YXG001/Vacuum-3d-printer-ender3-/CAD_V2/line_base.STEP

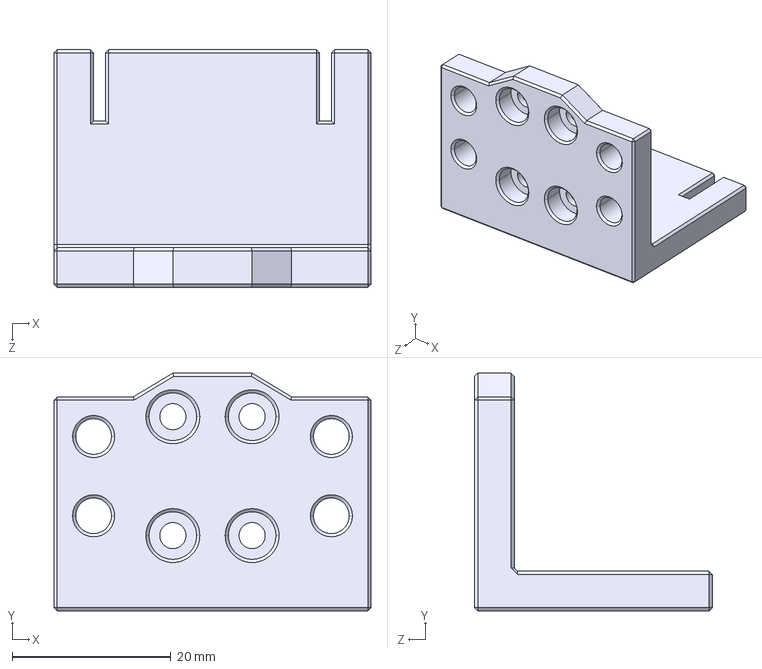
[picture p44: CAD file, 2025-03-07]
CAD_V2/line_base.STEP
40.0 x 30.0 x 30.0 mm
