YXG001/Vacuum-3d-printer-ender3-/mgn9c.SLDPRT

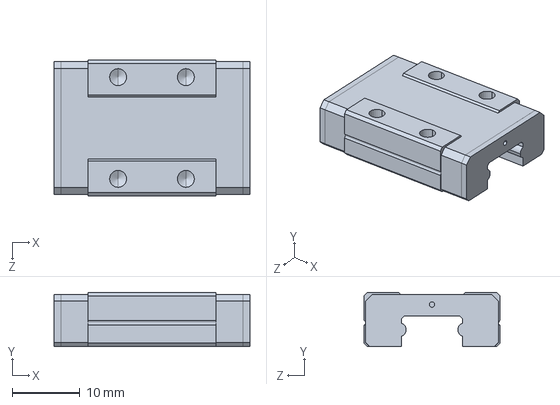
[picture p45: CAD file, 2025-03-07]
mgn9c.SLDPRT
28.9 x 8.00 x 20.0 mm
