YXG001/Vacuum-3d-printer-ender3-/CAD_V2/V6_ad_2_down.STEP

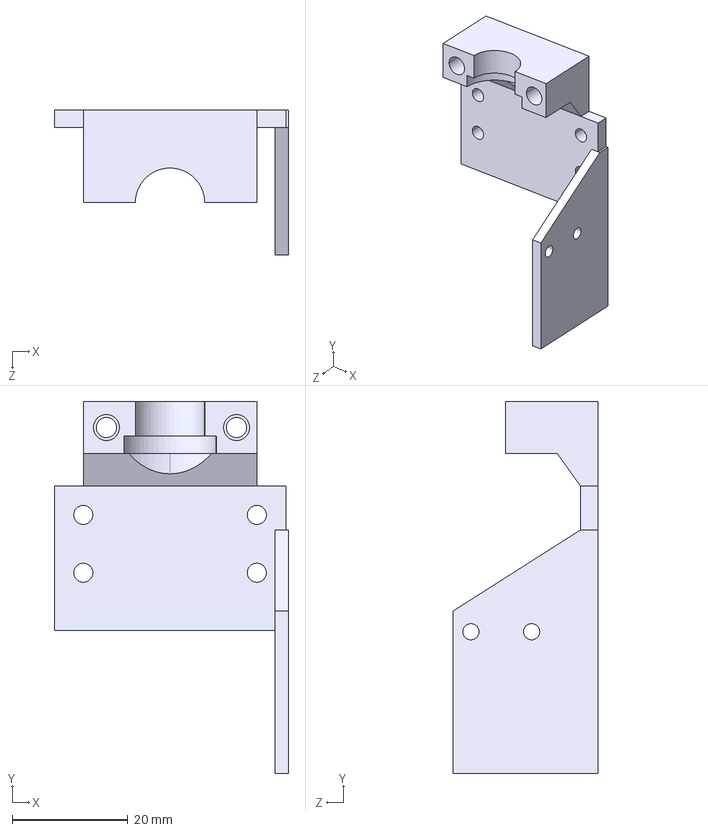
[picture p46: CAD file, 2025-03-07]
CAD_V2/V6_ad_2_down.STEP
40.5 x 64.3 x 25.0 mm
