YXG001/Vacuum-3d-printer-ender3-/mgnr9.SLDPRT

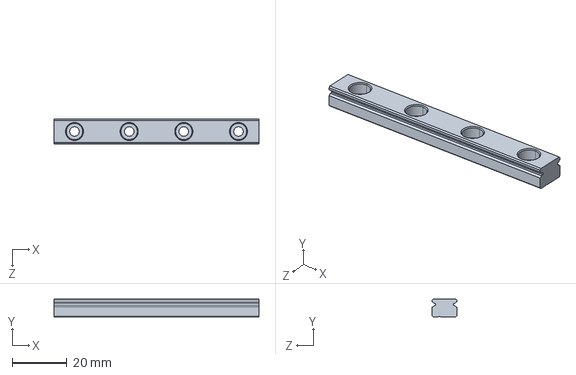
[picture p47: CAD file, 2025-03-07]
mgnr9.SLDPRT
75.0 x 6.50 x 9.00 mm
