YXG001/Vacuum-3d-printer-ender3-/CAD_V2/V6_ad_2_up.STEP

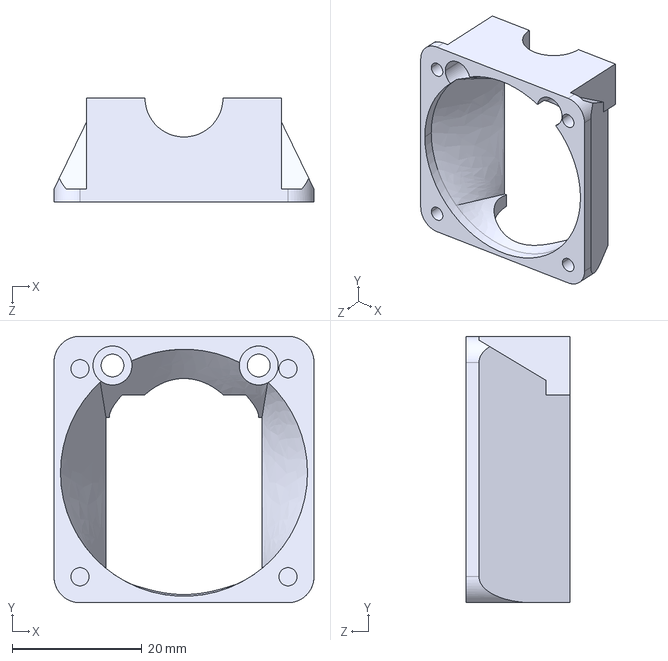
[picture p48: CAD file, 2025-03-07]
CAD_V2/V6_ad_2_up.STEP
40.0 x 41.0 x 16.0 mm
