YXG001/Vacuum-3d-printer-ender3-/CAD_V2/V6_ad_2a.SLDPRT

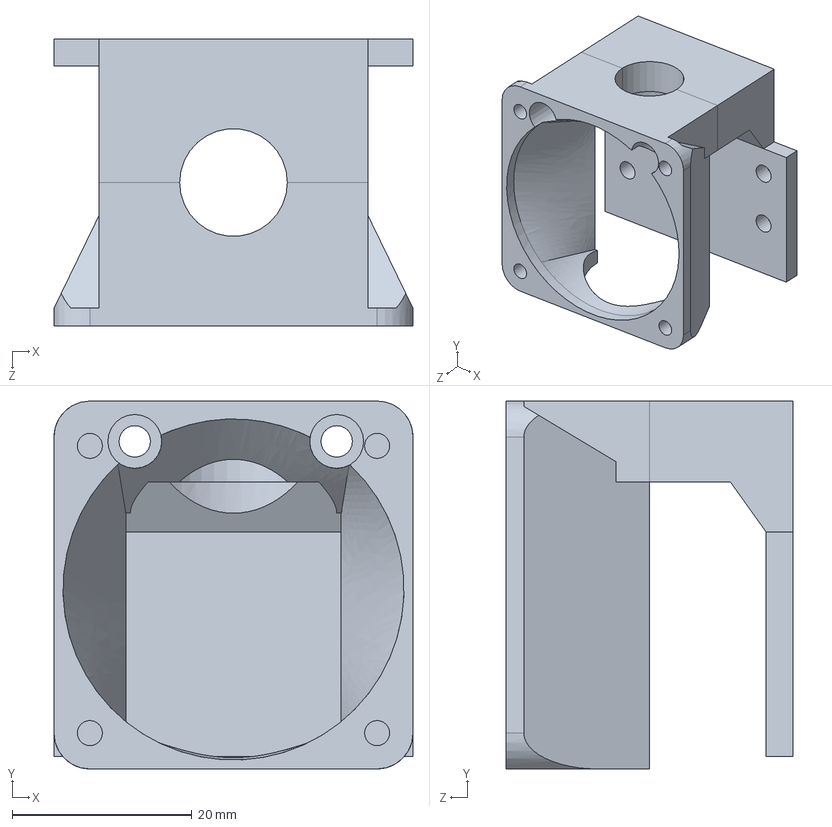
[picture p49: CAD file, 2025-03-07]
CAD_V2/V6_ad_2a.SLDPRT
40.0 x 41.0 x 32.0 mm
