YXG001/Vacuum-3d-printer-ender3-/CAD_V2/V6_ad.STEP

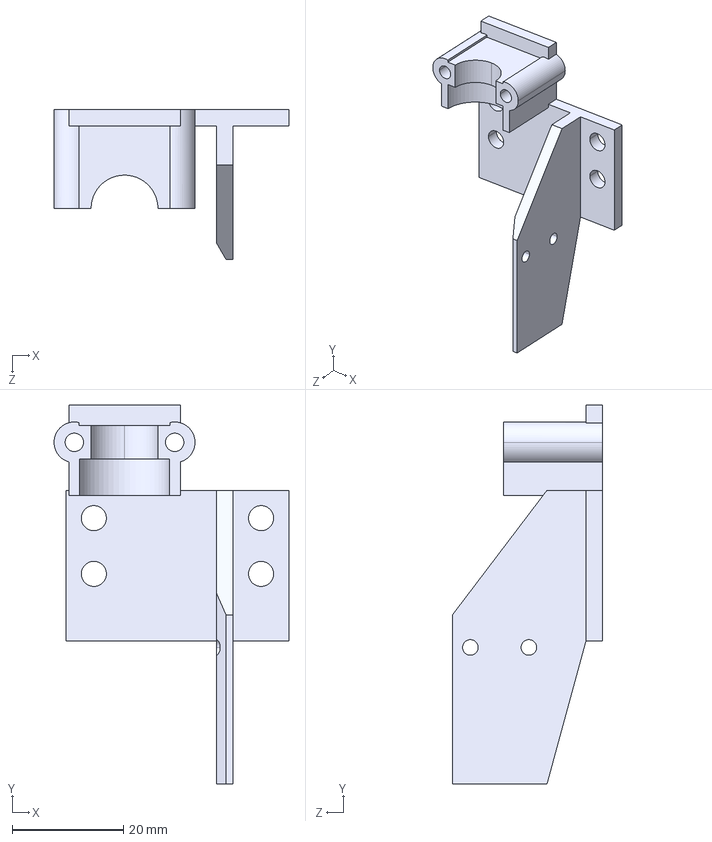
[picture p50: CAD file, 2025-02-25]
CAD_V2/V6_ad.STEP
42.1 x 68.0 x 27.0 mm
