YXG001/Vacuum-3d-printer-ender3-/CAD/newest/V6_adapter_up.STEP

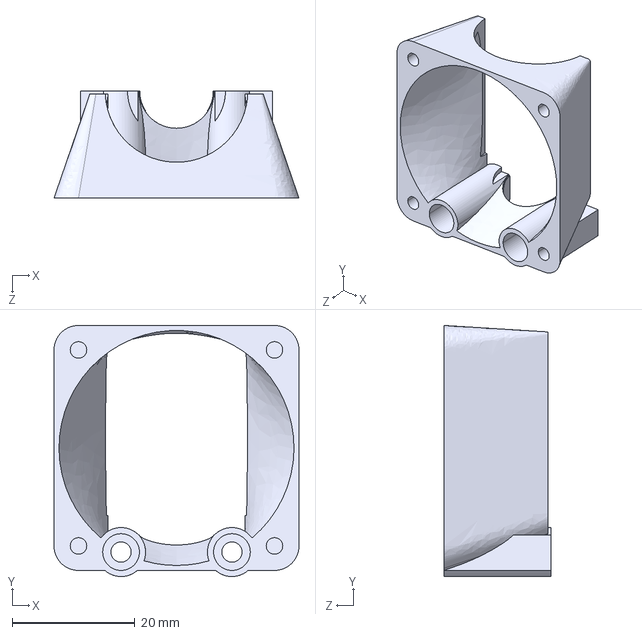
[picture p51: CAD file, 2025-02-25, an earlier design]
CAD/newest/V6_adapter_up.STEP
40.0 x 41.0 x 17.5 mm
