YXG001/Vacuum-3d-printer-ender3-/CAD/old/ender3_v.STEP

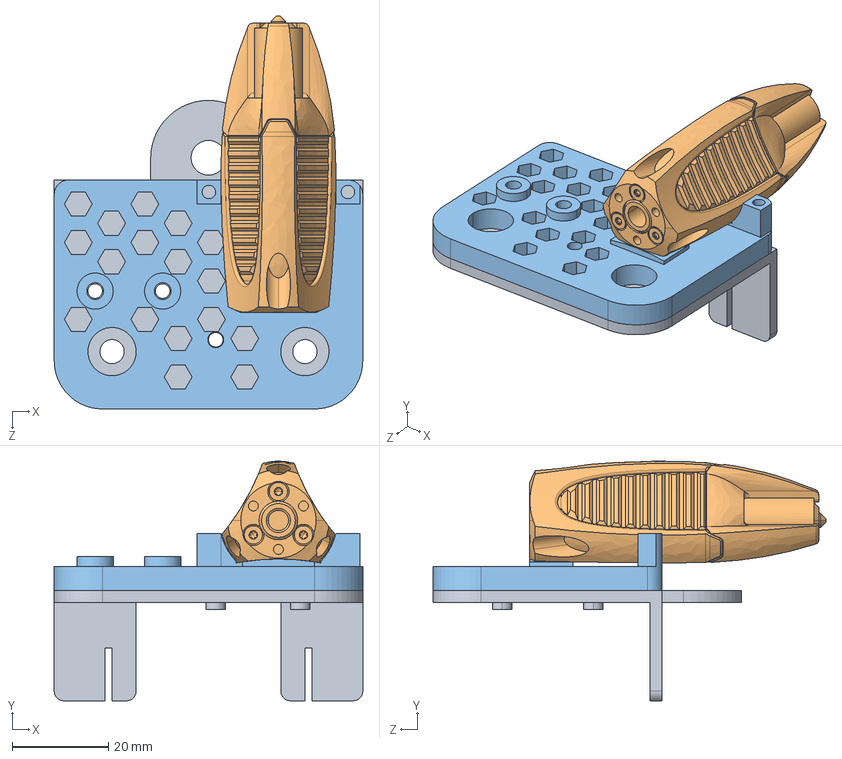
[picture p52: CAD file, 2025-01-16, an earlier design]
CAD/old/ender3_v.STEP
64.0 x 49.7 x 81.5 mm
ender3_文件夹 333
INo Trident Mockup 032023
ender3_ad
