YXG001/Vacuum-3d-printer-ender3-/CAD/newest/ender3_v5.SLDASM

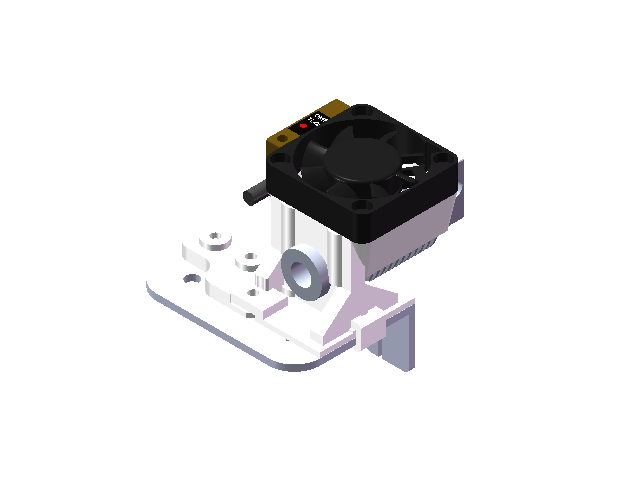
[picture p53: CAD file, 2025-02-13, an earlier design]
CAD/newest/ender3_v5.SLDASM
ender3_文件夹 333(2)
ender3_ad5B
OMRON TL-Q5MC1-Z
ender3_ad5C
e3d nozzle (0.4)
e3d heaterblock
e3d heat break
e3d heatsink
V6_adapter_down
404010 fan v5
V6_adapter_up
