YXG001/Vacuum-3d-printer-ender3-/CAD/newest/INO_head.SLDASM

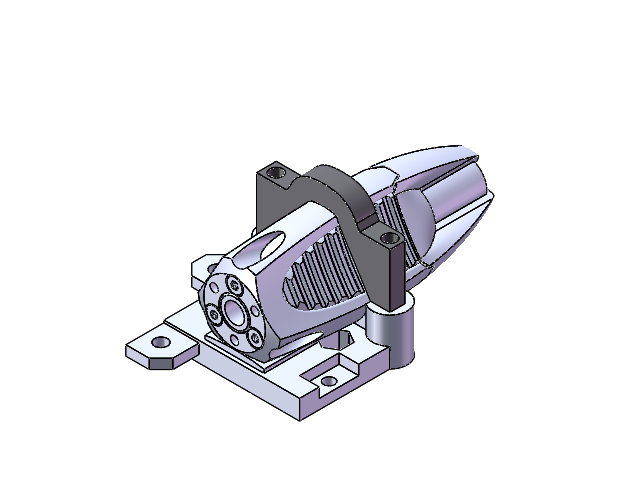
[picture p54: CAD file, 2025-02-13, an earlier design]
CAD/newest/INO_head.SLDASM
ender3_ad
INo Trident Mockup 032023(2)
eBom-FreeParts
