YXG001/Vacuum-3d-printer-ender3-/CAD/ender3_v.STEP.SLDASM

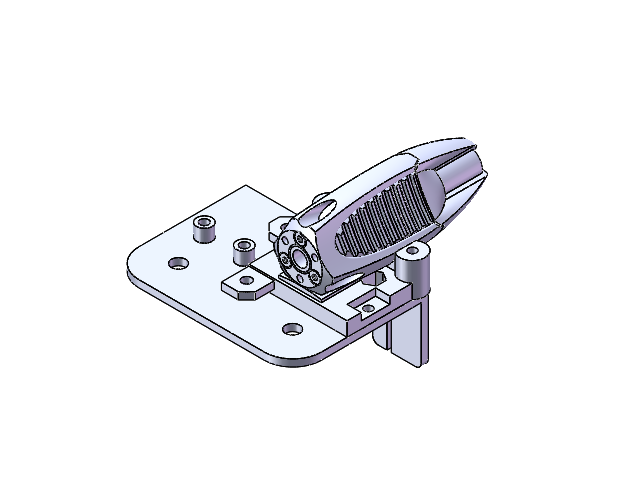
[picture p55: CAD file, 2025-02-13, an earlier design]
CAD/ender3_v.STEP.SLDASM
ender3_ad
INo Trident Mockup 032023(2)
ender3_文件夹 333(2)
