YXG001/Vacuum-3d-printer-ender3-/CAD/ender3_v3.SLDASM

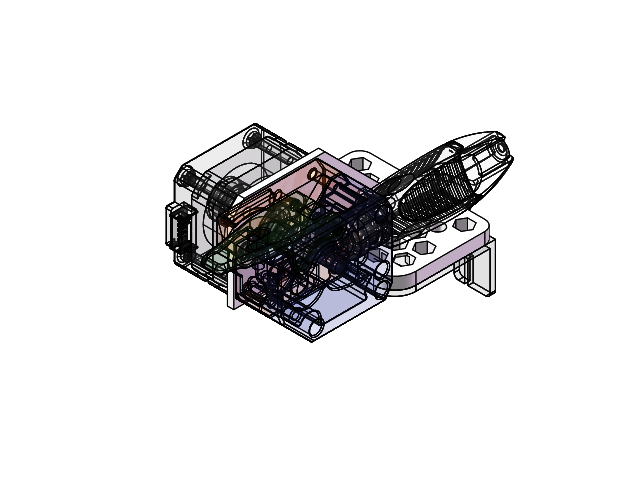
[picture p56: CAD file, 2025-01-16, an earlier design]
CAD/ender3_v3.SLDASM
ender3_文件夹 333
ender3_ad3
INo Trident Mockup 032023
Lever
BMG bottom part
e3d slimline stepper motor 0.9deg v1.1
bmg_ad2
