YXG001/Vacuum-3d-printer-ender3-/CAD/ender3_v-ASUS.SLDASM

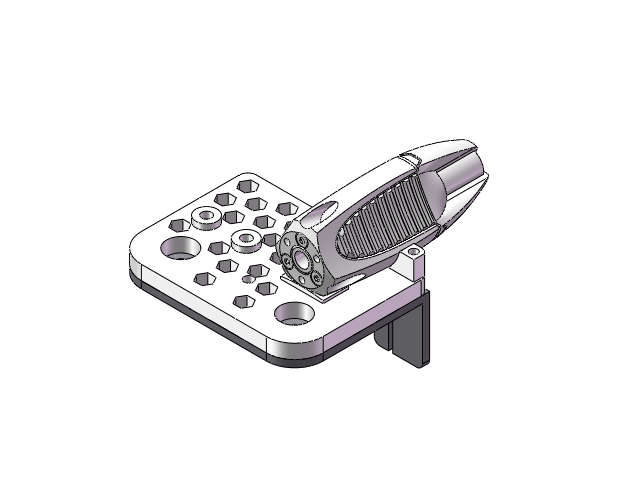
[picture p59: CAD file, 2025-01-16, an earlier design]
CAD/ender3_v-ASUS.SLDASM
ender3_文件夹 333
INo Trident Mockup 032023
ender3_ad
