YXG001/Vacuum-3d-printer-ender3-/CAD/PCB base.SLDASM

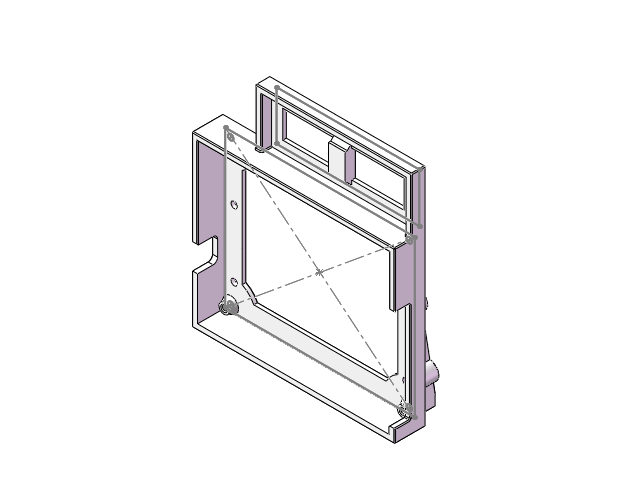
[picture p60: CAD file, 2025-01-16, an earlier design]
CAD/PCB base.SLDASM
INO base down
INO base down2
