YXG001/Vacuum-3d-printer-ender3-/(list of files, cad)

Other CAD files:
CAD/root.SLDASM
CAD/404010 fan v5.SLDPRT
CAD/Ender3_文件夹 333.step
CAD/Hotend v6.step
CAD/INO base.STEP
CAD/INo Trident Mockup 032023(2).SLDPRT
CAD/INo Trident Mockup 032023.SLDPRT
CAD/INo Trident Mockup 032023.step
CAD/bmg_ad.SLDPRT
CAD/bmg_ad.STEP
CAD/bmg_ad2.SLDPRT
CAD/bmg_ad2.STEP
CAD/bmg_bs1.SLDPRT
CAD/bmg_bs1.STEP
CAD/eBom-FreeParts.SLDPRT
CAD/ender3_ad-ASUS.SLDPRT
CAD/ender3_ad.SLDPRT
CAD/ender3_ad.STEP
CAD/ender3_ad2.SLDPRT
CAD/ender3_ad2.STEP
CAD/ender3_ad3.SLDPRT
CAD/ender3_ad3.STEP
CAD/ender3_ad5B.SLDPRT
CAD/ender3_ad5B.STEP
CAD/ender3_ad5C.SLDPRT
CAD/ender3_ad5C.STEP
CAD/ender3_v(1).SLDASM
CAD/ender3_v(1).step
CAD/ender3_v.SLDASM
CAD/ender3_v5.STEP
CAD/ender3_文件夹 333(2).SLDPRT
CAD/ender3_文件夹 333.SLDPRT
CAD/newest/OMRON TL-Q5MC1-Z.SLDPRT
CAD/newest/V6_adapter_down.3mf
CAD/newest/V6_adapter_down.SLDPRT
CAD/newest/V6_adapter_down.STEP
CAD/newest/V6_adapter_up.SLDPRT
CAD/old/bmg_bs1.SLDPRT
CAD/old/bmg_bs1.STEP
CAD/old/ender3_ad-ASUS.SLDPRT
CAD/old/ender3_ad2.SLDPRT
CAD/old/ender3_ad2.STEP
CAD/old/ender3_ad3.SLDPRT
CAD/old/ender3_ad3.STEP
CAD/old/ender3_v.SLDASM
CAD/sensor_ad.SLDPRT
CAD/sensor_ad.STEP
CAD/新建文件夹/INO base down.SLDPRT
CAD/新建文件夹/INO base down.STEP
CAD/新建文件夹/INO base down2.SLDPRT
CAD/新建文件夹/INO base down2.STEP
CAD/新建文件夹/底板.SLDPRT
CAD/新建文件夹/底板.STEP
CAD/顶针.SLDPRT
CAD/顶针.STEP
CAD_V2/V6_ad.SLDPRT
CAD_V2/V6_ad_2_down.SLDPRT
CAD_V2/V6_ad_2_up.SLDPRT
CAD_V2/line_base.3mf
CAD_V2/line_base.SLDPRT
